lsiaagmi/RC-car-Capstone/image-1767561161862.jpg

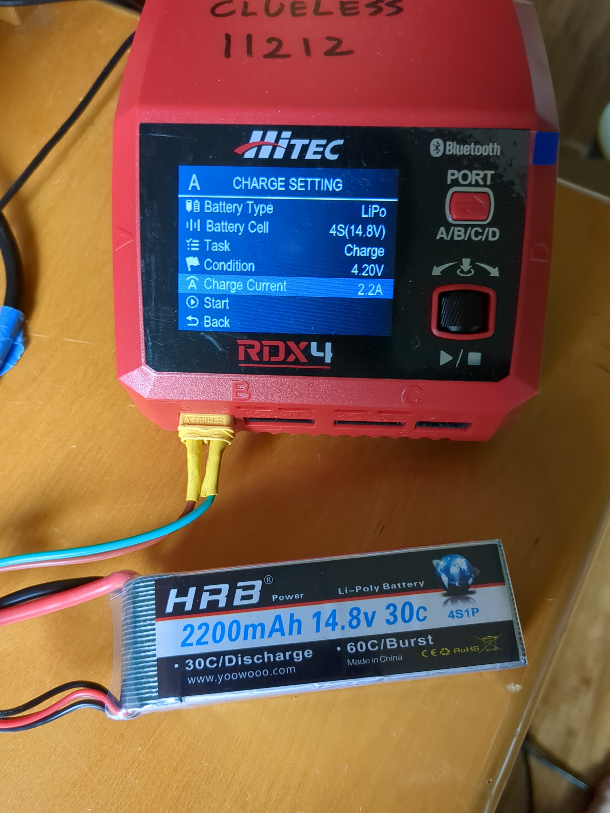
image-1767561161862.jpg
