lsiaagmi/RC-car-Capstone/PXL_20260105_160928560.jpg

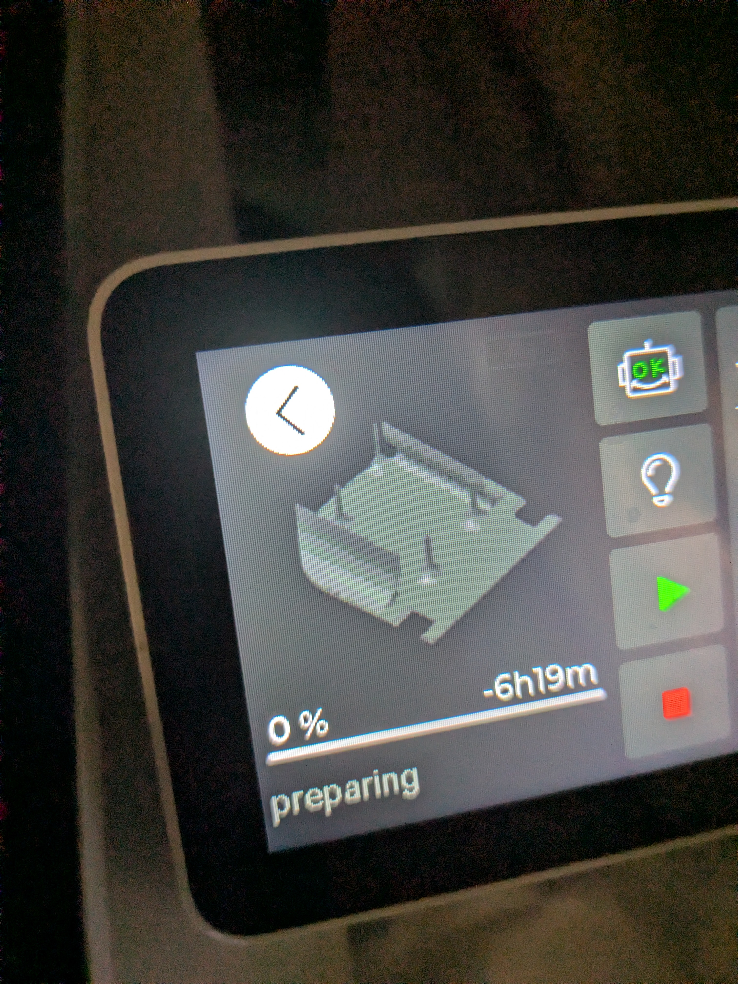
PXL_20260105_160928560.jpg
