lsiaagmi/RC-car-Capstone/PXL_20251228_020416410.jpg

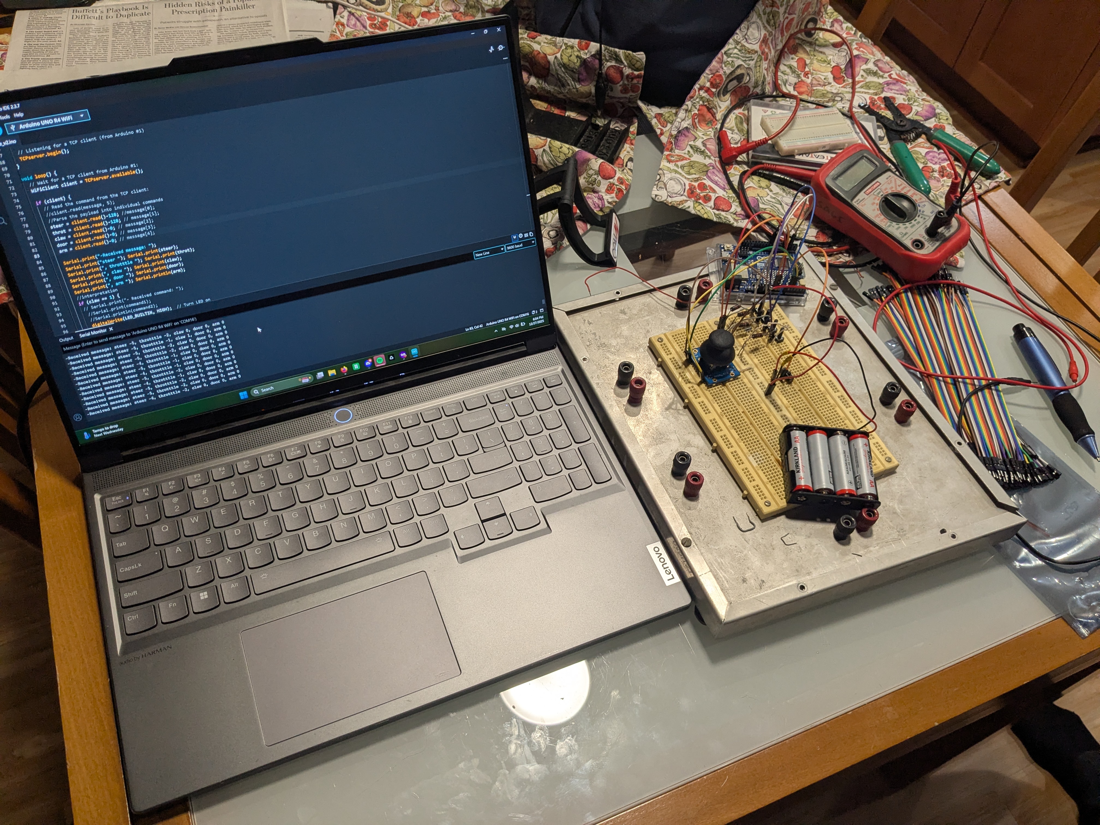
PXL_20251228_020416410.jpg
