lsiaagmi/RC-car-Capstone/PXL_20251228_020436312.jpg

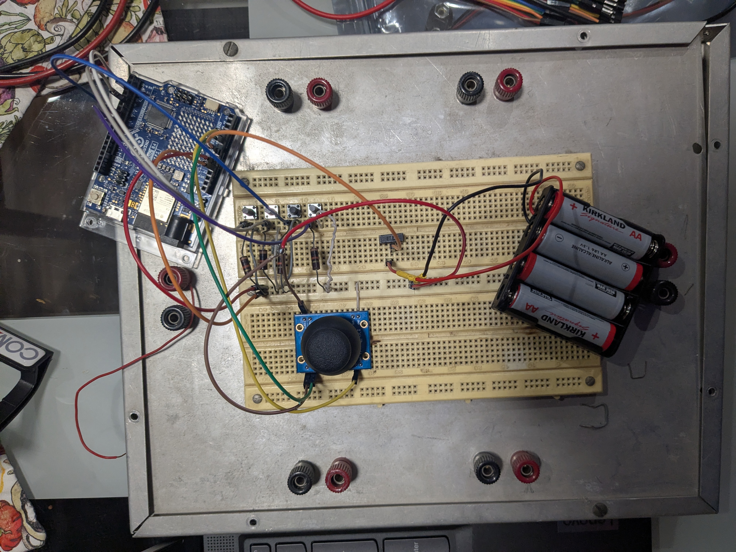
PXL_20251228_020436312.jpg
