lsiaagmi/RC-car-Capstone/PXL_20251228_061529201.jpg

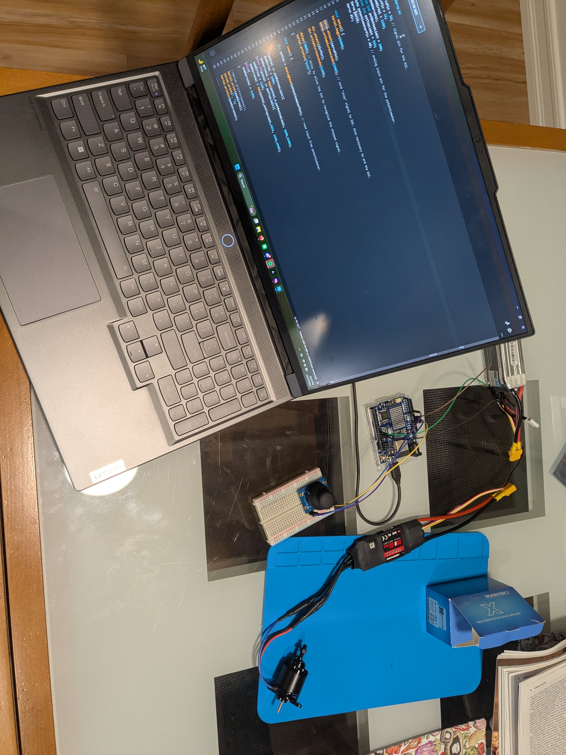
PXL_20251228_061529201.jpg
