lsiaagmi/RC-car-Capstone/PXL_20251228_214855445.jpg

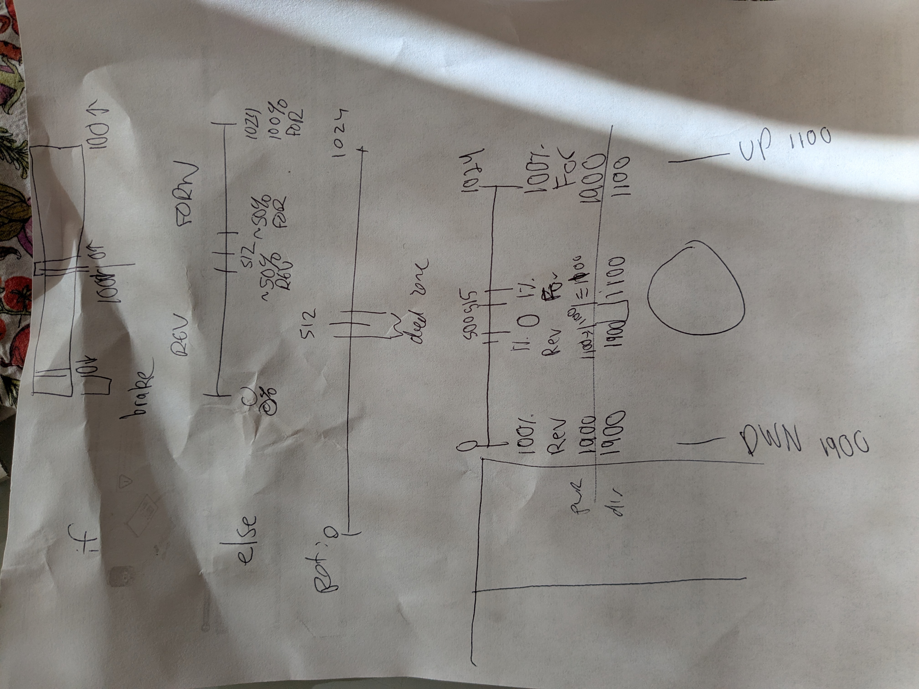
PXL_20251228_214855445.jpg
