lsiaagmi/RC-car-Capstone/PXL_20260102_090718714.jpg

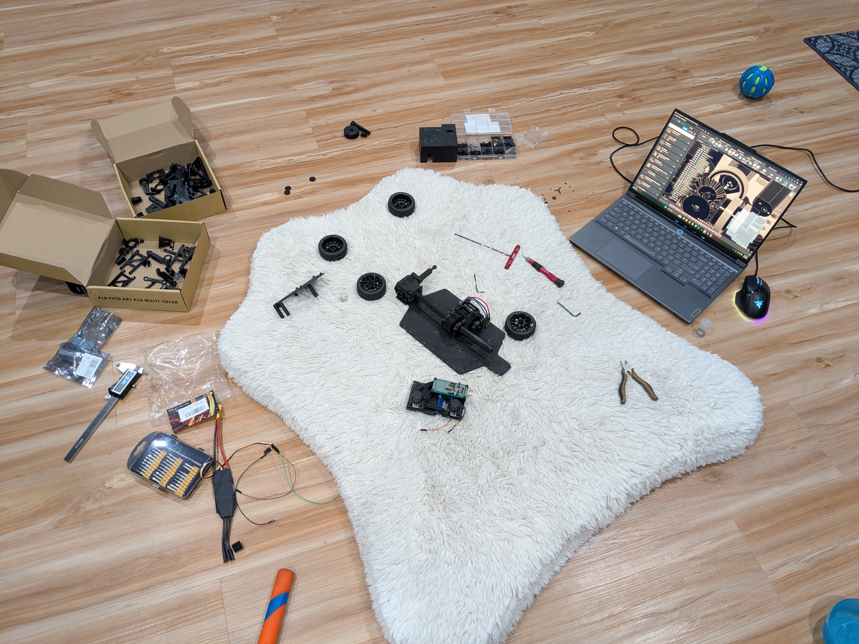
PXL_20260102_090718714.jpg
