lsiaagmi/RC-car-Capstone/PXL_20260103_064730178.jpg

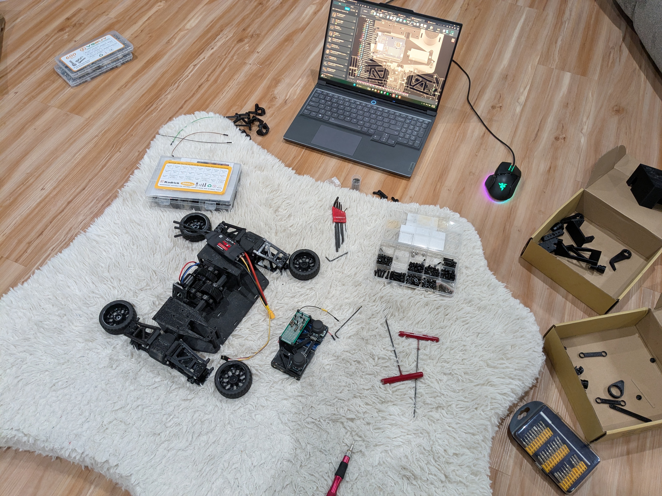
PXL_20260103_064730178.jpg
