lsiaagmi/RC-car-Capstone/PXL_20260103_064752812.jpg

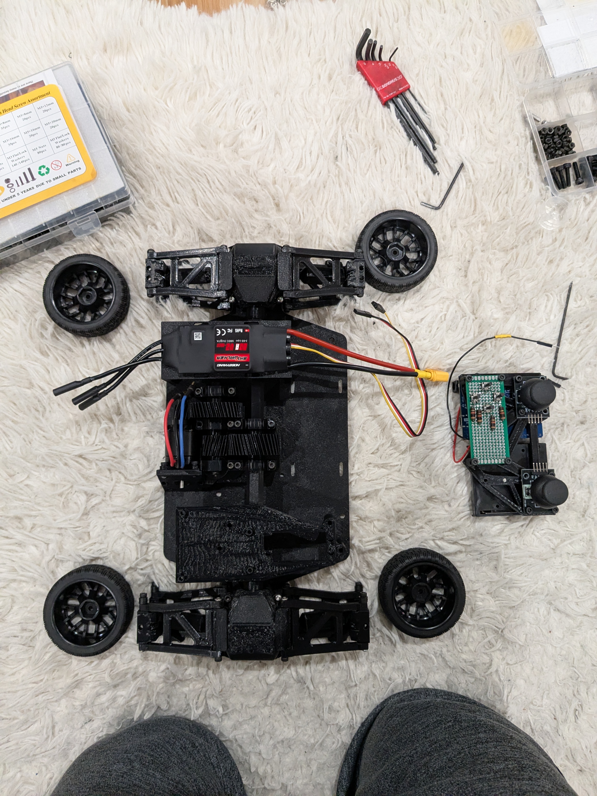
PXL_20260103_064752812.jpg
