lsiaagmi/RC-car-Capstone/PXL_20260104_065733397.jpg

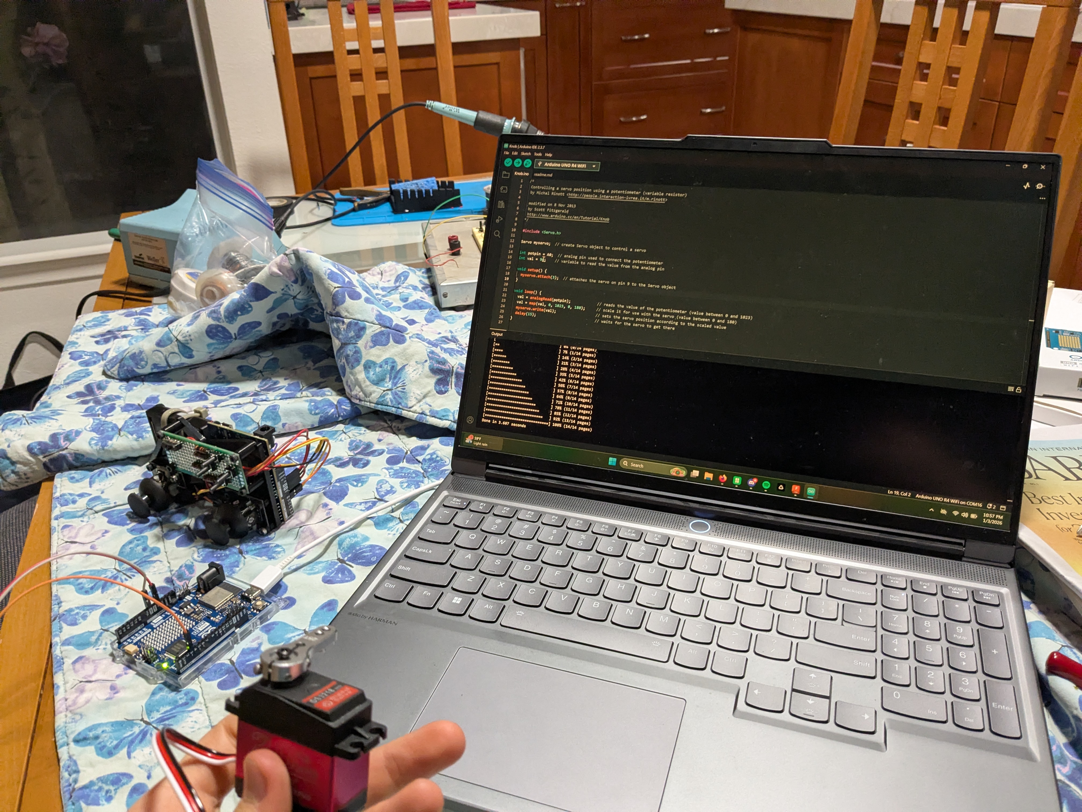
PXL_20260104_065733397.jpg
