lsiaagmi/RC-car-Capstone/PXL_20260104_092328609.jpg

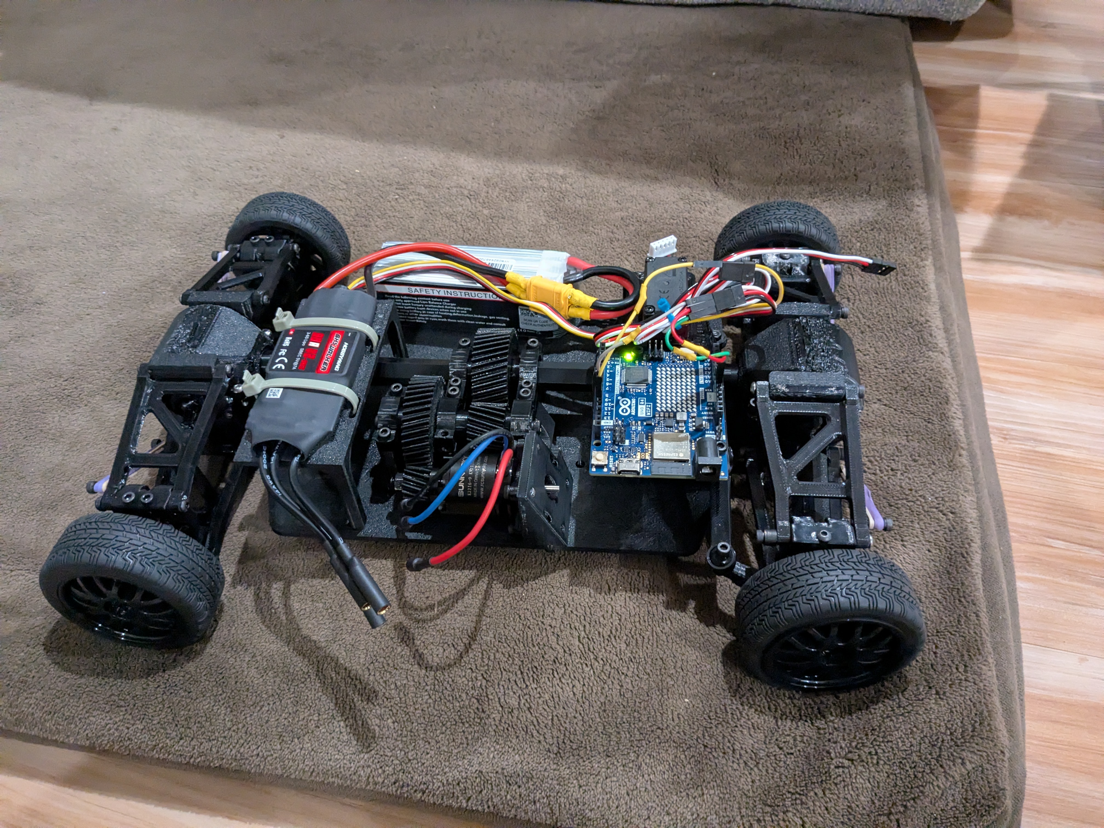
PXL_20260104_092328609.jpg
