lsiaagmi/RC-car-Capstone/PXL_20260104_092357547.jpg

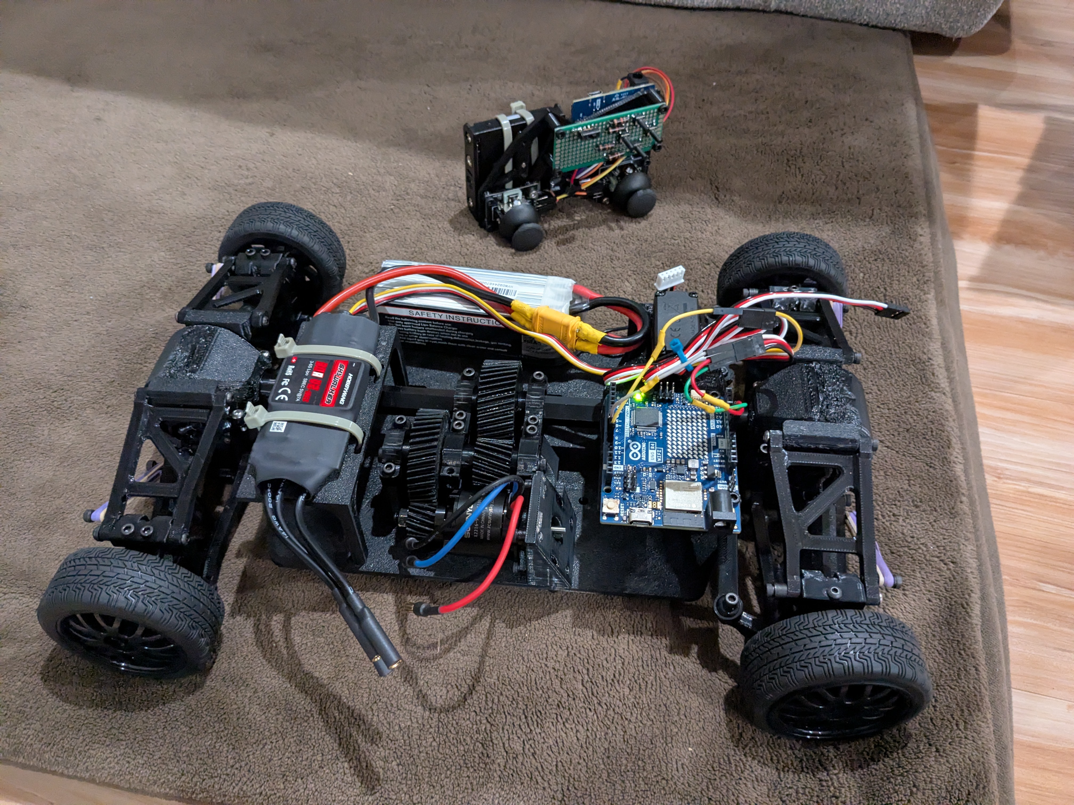
PXL_20260104_092357547.jpg
