lsiaagmi/RC-car-Capstone/PXL_20260107_055337075.jpg

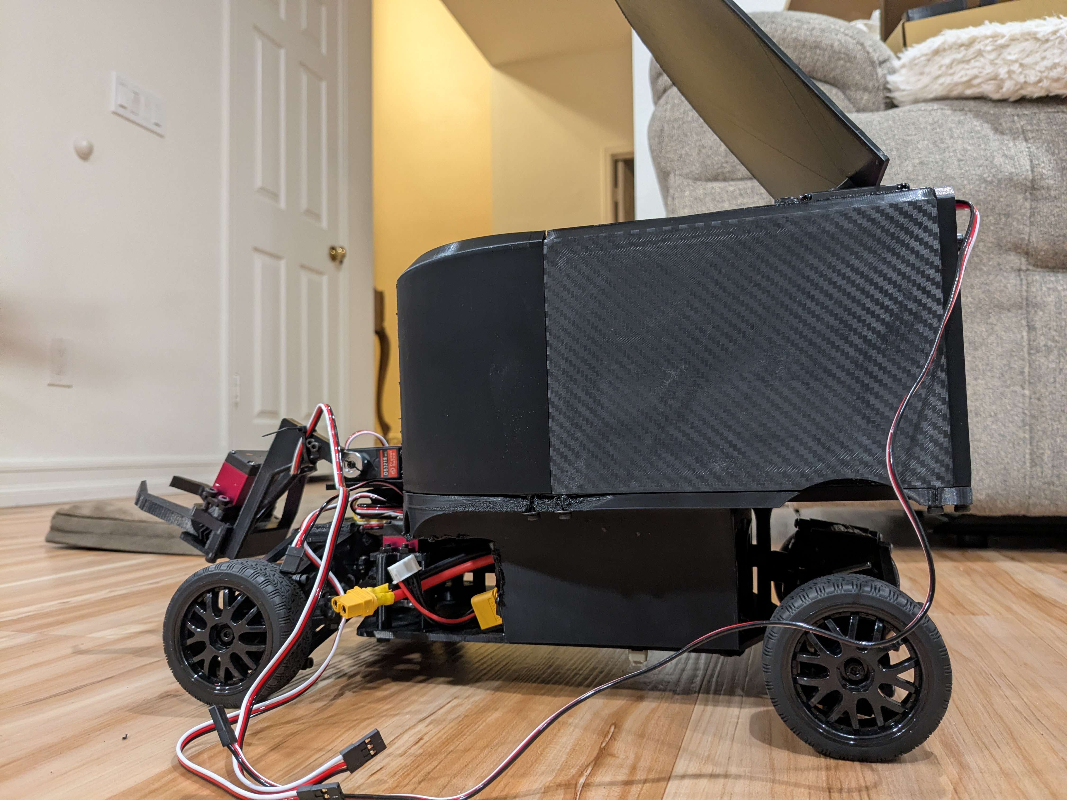
PXL_20260107_055337075.jpg
