lsiaagmi/RC-car-Capstone/PXL_20260109_005525015.jpg

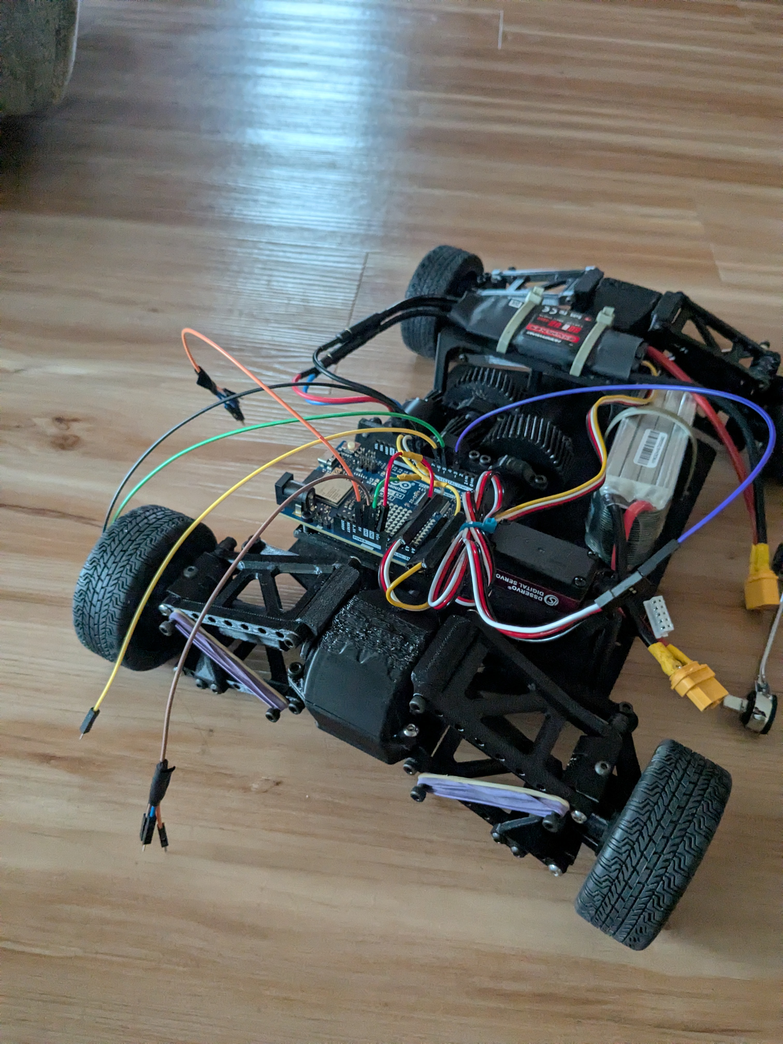
PXL_20260109_005525015.jpg
